MartijnBraam/usb-sniffer/hardware/usb-sniffer.kicad_sch

## KiCad design hardware/usb-sniffer.kicad_sch (2023-06-14)

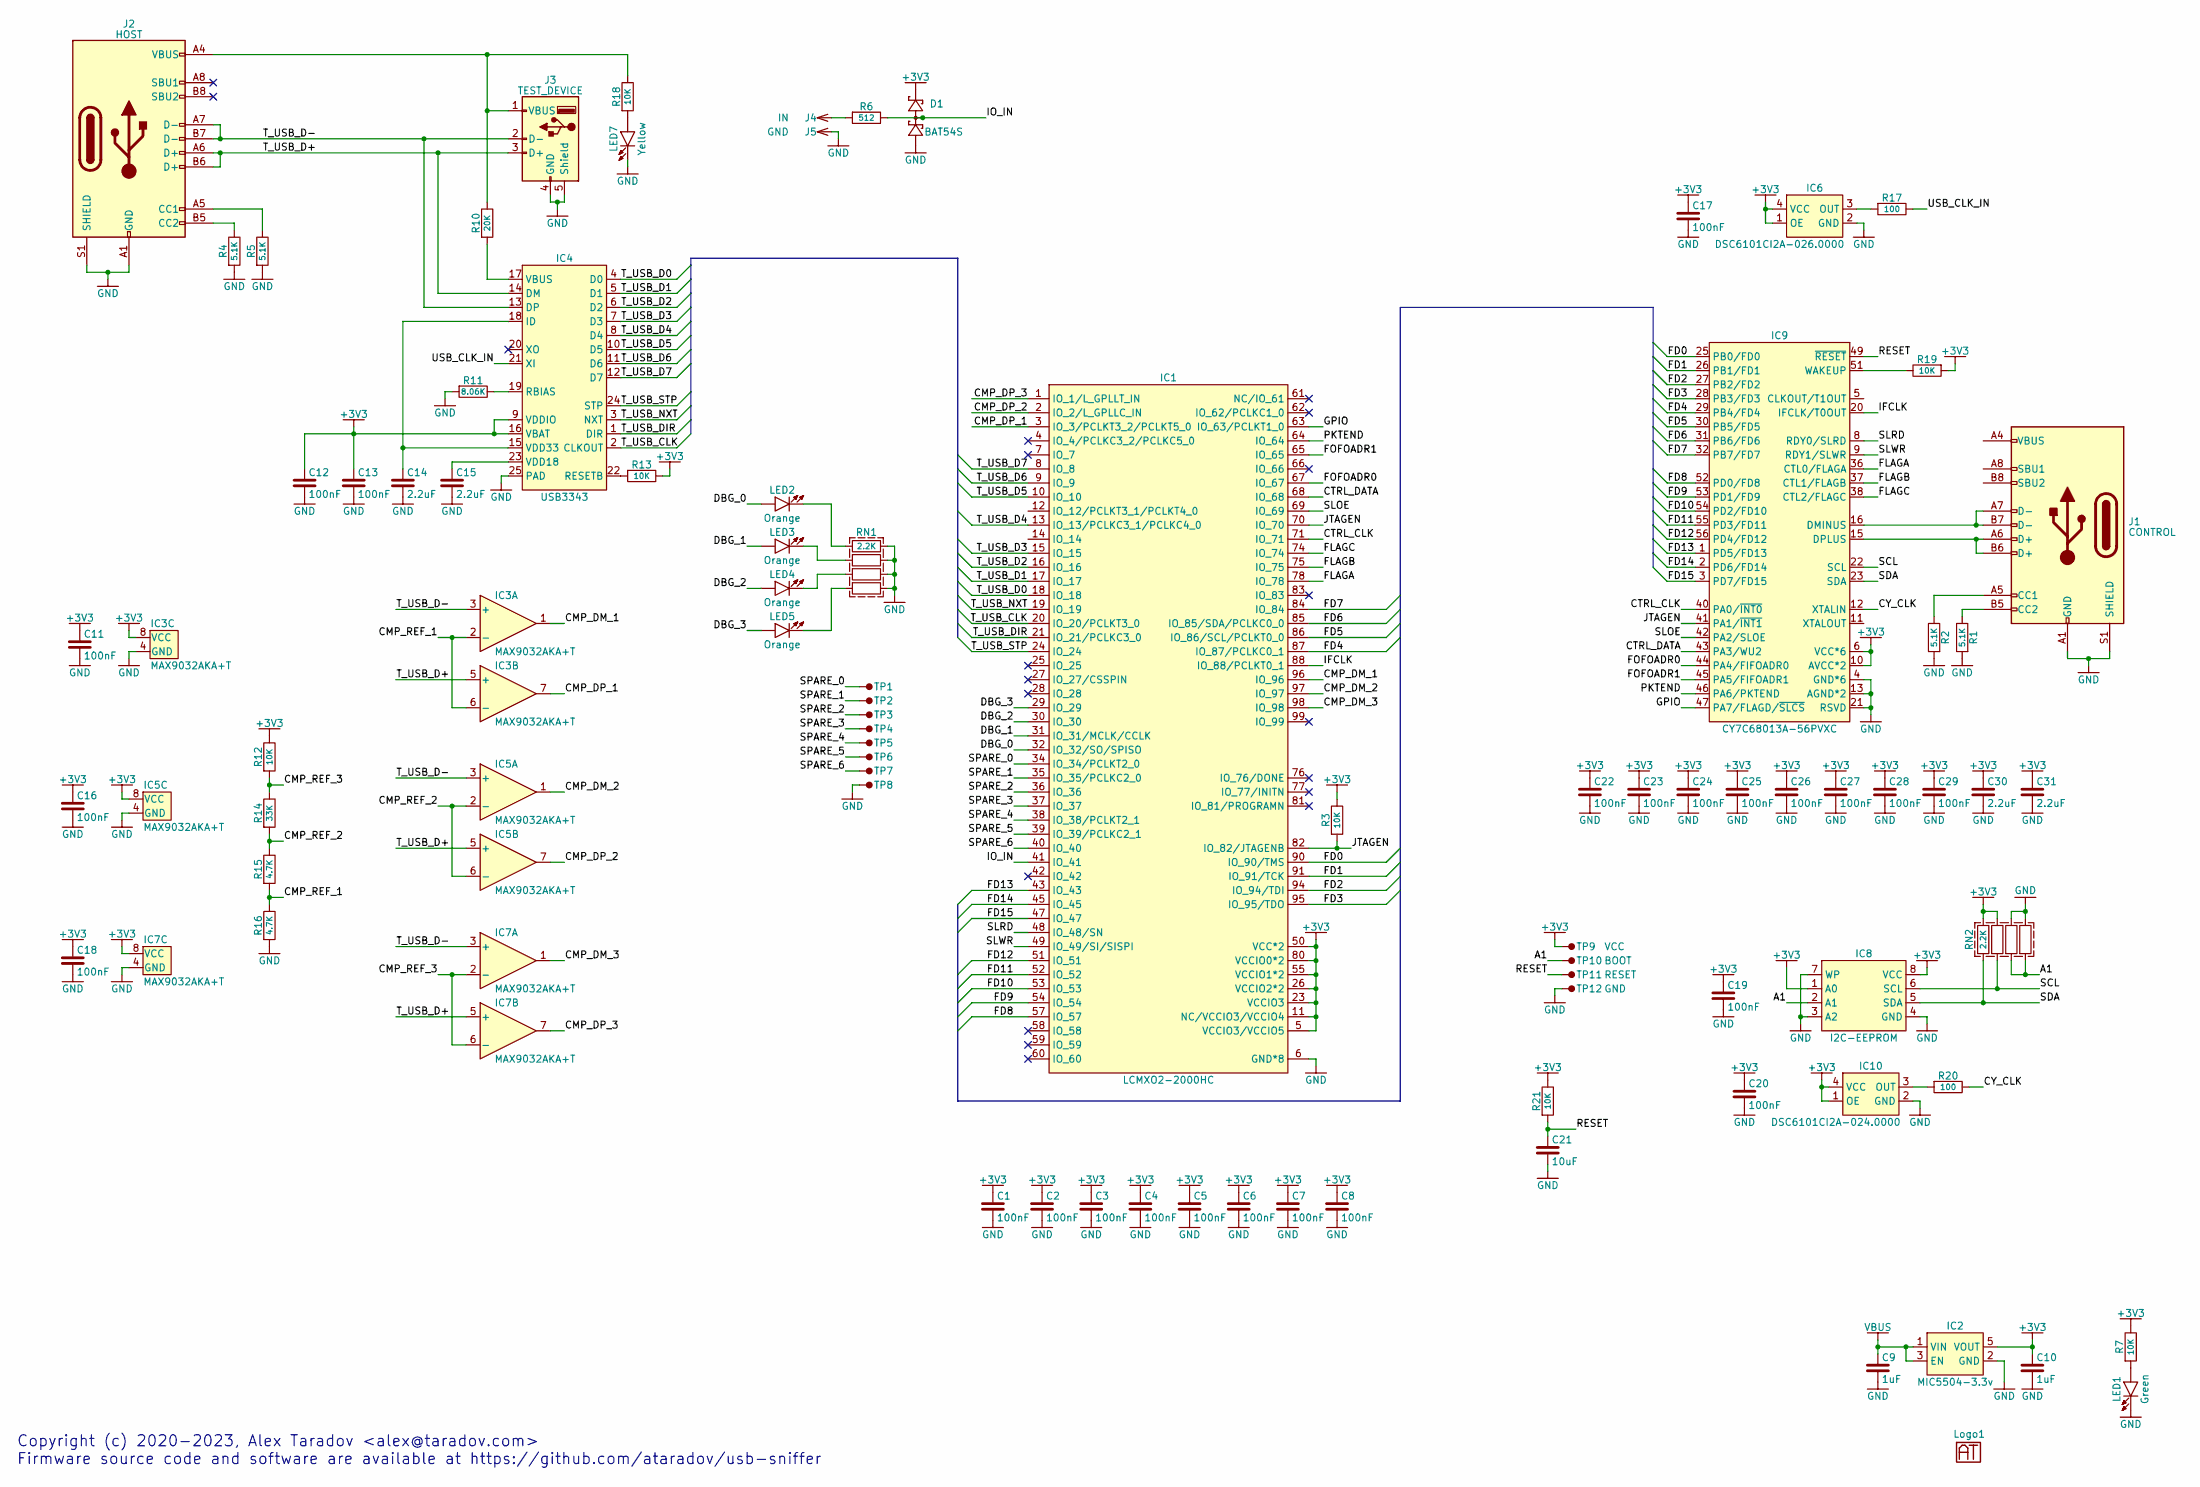
[picture p1: schematic usb-sniffer.kicad_sch]

Parts:
C1, C2, C3, C4, C5, C6, C7, C8, C11, C12, C13, C16, C17, C18, C19, C20, C22, C23, C24, C25, C26, C27, C28, C29: 100nF; 0603
C9, C10: 1uF; 0603
C14, C15, C30, C31: 2.2uF; 0603
C21: 10uF; 0603
D1: BAT54S; SOT-23
IC1: LCMXO2-2000HC; TQFP-100-0.5mm
IC2: MIC5504-3.3v; SOT-23-5
IC3, IC5, IC7: MAX9032AKA+T; SOT-23-8
IC4: USB3343; QFN-24-0.5mm
IC6: DSC6101CI2A-026.0000; CDFN-4-3.2x2.5mm
IC8: I2C-EEPROM; SO-8
IC9: CY7C68013A-56PVXC; SSOP-56-0.635mm
IC10: DSC6101CI2A-024.0000; CDFN-4-3.2x2.5mm
J1: CONTROL
J2: HOST
J3: TEST_DEVICE
J4: IN; Pin-2.54mm
J5: GND; Pin-2.54mm
LED1: Green; 0603
LED2, LED3, LED4, LED5: Orange; 0603
LED7: Yellow; 0603
Logo1: Logo; Logo-Small
R1, R2, R4, R5: 5.1K; 0603
R3, R7, R12, R13, R18, R19, R21: 10K; 0603
R6: 512; 0603
R10: 20K; 0603
R11: 8.06K; 0603
R14: 33K; 0603
R15, R16: 4.7K; 0603
R17, R20: 100; 0603
RN1, RN2: 2.2K; 0603x4
TP1, TP2, TP3, TP4, TP5, TP6, TP7, TP8: TestPoint-1.27mm-Small
TP9: VCC; TestPoint-1.27mm
TP10: BOOT; TestPoint-1.27mm
TP11: RESET; TestPoint-1.27mm
TP12: GND; TestPoint-1.27mm

Connections:
+3V3: C1.2, C2.2, C3.2, C4.2, C5.2, C6.2, C7.2, C8.2, C10.2, C11.2, C12.2, C13.2, C16.2, C17.2, C18.2, C19.2, C20.2, C22.2, C23.2, C24.2, C25.2, C26.2, C27.2, C28.2, C29.2, C30.2, C31.2, D1.2, IC1.5 (VCCIO3/VCCIO5), IC1.11 (NC/VCCIO3/VCCIO4), IC1.23 (VCCIO3), IC1.26 (VCCIO2*2), IC1.46 (VCCIO2), IC1.50 (VCC*2), IC1.55 (VCCIO1*2), IC1.73 (VCCIO1), IC1.80 (VCCIO0*2), IC1.93 (VCCIO0), IC1.100 (VCC), IC2.5 (VOUT), IC3.8 (VCC), IC4.9 (VDDIO), IC4.16 (VBAT), IC5.8 (VCC), IC6.1 (OE), IC6.4 (VCC), IC7.8 (VCC), IC8.1 (A0), IC8.8 (VCC), IC9.6 (VCC*6), IC9.10 (AVCC*2), IC9.14 (AVCC), IC9.18 (VCC), IC9.24 (VCC), IC9.34 (VCC), IC9.39 (VCC), IC9.50 (VCC), IC10.1 (OE), IC10.4 (VCC), R3.2, R7.2, R12.2, R13.2, R19.1, R21.2, RN2.7, RN2.8, TP9.1
A1: IC8.2 (A1), RN2.3, RN2.4, TP10.1
CMP_DM_1: IC1.96 (IO_96), IC3.1
CMP_DM_2: IC1.97 (IO_97), IC5.1
CMP_DM_3: IC1.98 (IO_98), IC7.1
CMP_DP_1: IC1.3 (IO_3/PCLKT3_2/PCLKT5_0), IC3.7
CMP_DP_2: IC1.2 (IO_2/L_GPLLC_IN), IC5.7
CMP_DP_3: IC1.1 (IO_1/L_GPLLT_IN), IC7.7
CMP_REF_1: IC3.2 (-), IC3.6 (-), R15.1, R16.2
CMP_REF_2: IC5.2 (-), IC5.6 (-), R14.1, R15.2
CMP_REF_3: IC7.2 (-), IC7.6 (-), R12.1, R14.2
CTRL_CLK: IC1.71 (IO_71), IC9.40 (PA0/~INT0)
CTRL_DATA: IC1.68 (IO_68), IC9.43 (PA3/WU2)
CY_CLK: IC9.12 (XTALIN), R20.2
DBG_0: IC1.32 (IO_32/SO/SPISO), LED2.1 (A)
DBG_1: IC1.31 (IO_31/MCLK/CCLK), LED3.1 (A)
DBG_2: IC1.30 (IO_30), LED4.1 (A)
DBG_3: IC1.29 (IO_29), LED5.1 (A)
FD0: IC1.90 (IO_90/TMS), IC9.25 (PB0/FD0)
FD1: IC1.91 (IO_91/TCK), IC9.26 (PB1/FD1)
FD2: IC1.94 (IO_94/TDI), IC9.27 (PB2/FD2)
FD3: IC1.95 (IO_95/TDO), IC9.28 (PB3/FD3)
FD4: IC1.87 (IO_87/PCLKC0_1), IC9.29 (PB4/FD4)
FD5: IC1.86 (IO_86/SCL/PCLKT0_0), IC9.30 (PB5/FD5)
FD6: IC1.85 (IO_85/SDA/PCLKC0_0), IC9.31 (PB6/FD6)
FD7: IC1.84 (IO_84), IC9.32 (PB7/FD7)
FD8: IC1.57 (IO_57), IC9.52 (PD0/FD8)
FD9: IC1.54 (IO_54), IC9.53 (PD1/FD9)
FD10: IC1.53 (IO_53), IC9.54 (PD2/FD10)
FD11: IC1.52 (IO_52), IC9.55 (PD3/FD11)
FD12: IC1.51 (IO_51), IC9.56 (PD4/FD12)
FD13: IC1.43 (IO_43), IC9.1 (PD5/FD13)
FD14: IC1.45 (IO_45), IC9.2 (PD6/FD14)
FD15: IC1.47 (IO_47), IC9.3 (PD7/FD15)
FLAGA: IC1.78 (IO_78), IC9.36 (CTL0/FLAGA)
FLAGB: IC1.75 (IO_75), IC9.37 (CTL1/FLAGB)
FLAGC: IC1.74 (IO_74), IC9.38 (CTL2/FLAGC)
FOFOADR0: IC1.67 (IO_67), IC9.44 (PA4/FIFOADR0)
FOFOADR1: IC1.65 (IO_65), IC9.45 (PA5/FIFOADR1)
GND: C1.1, C2.1, C3.1, C4.1, C5.1, C6.1, C7.1, C8.1, C9.1, C10.1, C11.1, C12.1, C13.1, C14.1, C15.1, C16.1, C17.1, C18.1, C19.1, C20.1, C21.1, C22.1, C23.1, C24.1, C25.1, C26.1, C27.1, C28.1, C29.1, C30.1, C31.1, D1.1, IC1.6 (GND*8), IC1.22 (GND), IC1.33 (GND), IC1.44 (GND), IC1.56 (GND), IC1.72 (GND), IC1.79 (GND), IC1.92 (GND), IC2.2 (GND), IC3.4 (GND), IC4.25 (PAD), IC5.4 (GND), IC6.2 (GND), IC7.4 (GND), IC8.3 (A2), IC8.4 (GND), IC8.7 (WP), IC9.4 (GND*6), IC9.7 (GND), IC9.13 (AGND*2), IC9.17 (AGND), IC9.19 (GND), IC9.21 (RSVD), IC9.33 (GND), IC9.35 (GND), IC9.48 (GND), IC10.2 (GND), J1.A1 (GND), J1.A12 (GND), J1.B1 (GND), J1.B12 (GND), J1.S1 (SHIELD), J2.A1 (GND), J2.A12 (GND), J2.B1 (GND), J2.B12 (GND), J2.S1 (SHIELD), J3.4 (GND), J3.5 (Shield), J5.1, LED1.2 (K), LED7.2 (K), R1.1, R2.1, R4.1, R5.1, R11.1, R16.1, RN1.5, RN1.6, RN1.7, RN1.8, RN2.5, RN2.6, TP8.1, TP12.1
GPIO: IC1.63 (IO_63/PCLKT1_0), IC9.47 (PA7/FLAGD/~SLCS)
IFCLK: IC1.88 (IO_88/PCLKT0_1), IC9.20 (IFCLK/T0OUT)
IO_IN: D1.3, IC1.41 (IO_41), R6.2
JTAGEN: IC1.70 (IO_70), IC1.82 (IO_82/JTAGENB), IC9.41 (PA1/~INT1), R3.1
unnamed: C14.2, IC4.15 (VDD33), IC4.18 (ID)
unnamed: C15.2, IC4.23 (VDD18)
unnamed: IC4.17 (VBUS), R10.1
unnamed: IC4.19 (RBIAS), R11.2
unnamed: IC4.22 (RESETB), R13.1
unnamed: IC6.3 (OUT), R17.1
unnamed: IC9.15 (DPLUS), J1.A6 (D+), J1.B6 (D+)
unnamed: IC9.16 (DMINUS), J1.A7 (D-), J1.B7 (D-)
unnamed: IC9.51 (WAKEUP), R19.2
unnamed: IC10.3 (OUT), R20.1
unnamed: J1.A4 (VBUS), J1.A9 (VBUS), J1.B4 (VBUS), J1.B9 (VBUS)
unnamed: J1.A5 (CC1), R2.2
unnamed: J1.B5 (CC2), R1.2
unnamed: J2.A4 (VBUS), J2.A9 (VBUS), J2.B4 (VBUS), J2.B9 (VBUS), J3.1 (VBUS), R10.2, R18.2
unnamed: J2.A5 (CC1), R5.2
unnamed: J2.B5 (CC2), R4.2
unnamed: J4.1, R6.1
unnamed: LED1.1 (A), R7.1
unnamed: LED2.2 (K), RN1.1
unnamed: LED3.2 (K), RN1.2
unnamed: LED4.2 (K), RN1.3
unnamed: LED5.2 (K), RN1.4
unnamed: LED7.1 (A), R18.1
PKTEND: IC1.64 (IO_64), IC9.46 (PA6/PKTEND)
RESET: C21.2, IC9.49 (~RESET), R21.1, TP11.1
SCL: IC8.6 (SCL), IC9.22 (SCL), RN2.2
SDA: IC8.5 (SDA), IC9.23 (SDA), RN2.1
SLOE: IC1.69 (IO_69), IC9.42 (PA2/SLOE)
SLRD: IC1.48 (IO_48/SN), IC9.8 (RDY0/SLRD)
SLWR: IC1.49 (IO_49/SI/SISPI), IC9.9 (RDY1/SLWR)
SPARE_0: IC1.34 (IO_34/PCLKT2_0), TP1.1
SPARE_1: IC1.35 (IO_35/PCLKC2_0), TP2.1
SPARE_2: IC1.36 (IO_36), TP3.1
SPARE_3: IC1.37 (IO_37), TP4.1
SPARE_4: IC1.38 (IO_38/PCLKT2_1), TP5.1
SPARE_5: IC1.39 (IO_39/PCLKC2_1), TP6.1
SPARE_6: IC1.40 (IO_40), TP7.1
T_USB_CLK: IC1.20 (IO_20/PCLKT3_0), IC4.2 (CLKOUT)
T_USB_D0: IC1.18 (IO_18), IC4.4 (D0)
T_USB_D1: IC1.17 (IO_17), IC4.5 (D1)
T_USB_D2: IC1.16 (IO_16), IC4.6 (D2)
T_USB_D3: IC1.15 (IO_15), IC4.7 (D3)
T_USB_D4: IC1.13 (IO_13/PCLKC3_1/PCLKC4_0), IC4.8 (D4)
T_USB_D5: IC1.10 (IO_10), IC4.10 (D5)
T_USB_D6: IC1.9 (IO_9), IC4.11 (D6)
T_USB_D7: IC1.8 (IO_8), IC4.12 (D7)
T_USB_D+: IC3.5 (+), IC4.14 (DM), IC5.5 (+), IC7.5 (+), J2.A6 (D+), J2.B6 (D+), J3.3 (D+)
T_USB_D-: IC3.3 (+), IC4.13 (DP), IC5.3 (+), IC7.3 (+), J2.A7 (D-), J2.B7 (D-), J3.2 (D-)
T_USB_DIR: IC1.21 (IO_21/PCLKC3_0), IC4.1 (DIR)
T_USB_NXT: IC1.19 (IO_19), IC4.3 (NXT)
T_USB_STP: IC1.24 (IO_24), IC4.24 (STP)
USB_CLK_IN: IC4.21 (XI), R17.2
VBUS: C9.2, IC2.1 (VIN), IC2.3 (EN)

Notes on the sheet:
Copyright (c) 2020-2023, Alex Taradov <alex@taradov.com> Firmware source code and software are available at https://github.com/ataradov/usb-sniffer
